divyansh0518/tendon-tactile-hand/docs/images/assembly_finger1.jpg

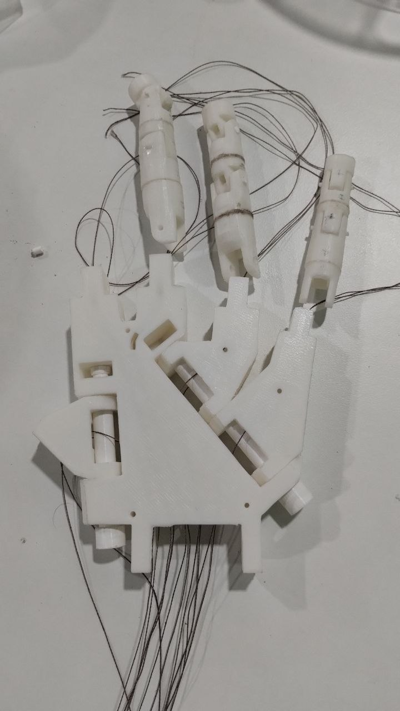
docs/images/assembly_finger1.jpg
