divyansh0518/tendon-tactile-hand/docs/images/assembly_servo.jpg

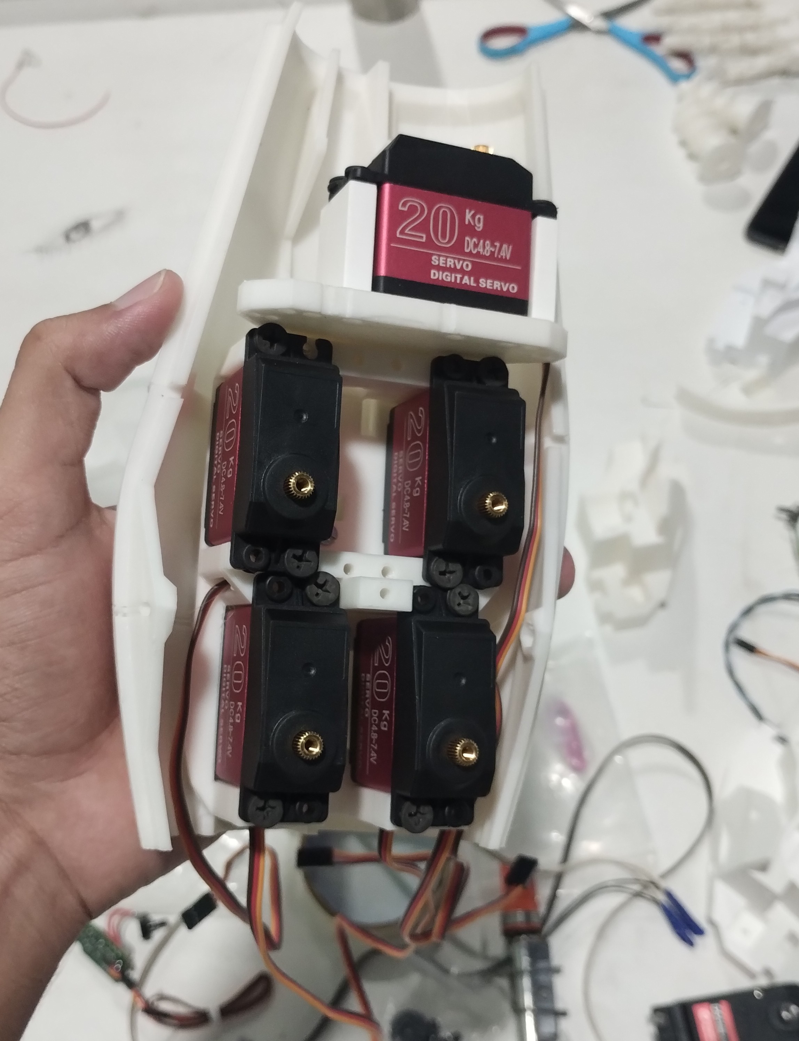
docs/images/assembly_servo.jpg
