divyansh0518/tendon-tactile-hand/docs/images/printing_02.jpg

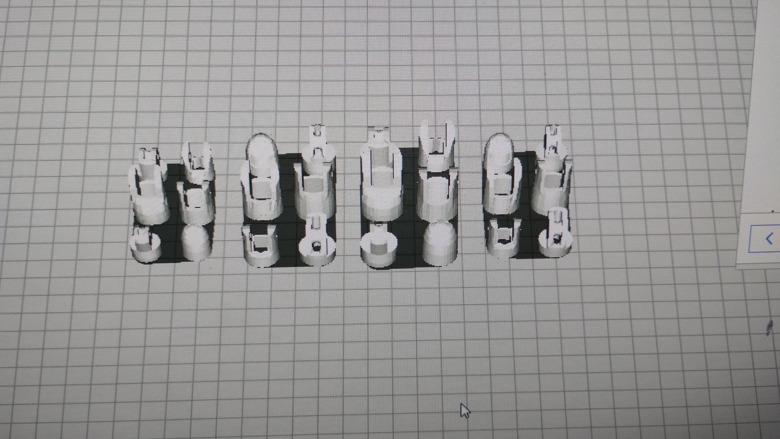
docs/images/printing_02.jpg
